Djoonk/ESP_Motor_test/(list of files, drawings)

Other design files:
Sheme/Motor_test.dch
Sheme/Motor_test.dip
