Djoonk/ESP_Motor_test/(commit log)

2026-07-24 Змінив команди з текстових на бінарні
2026-07-28 виправлено строку 142 uint8_t packet[4]
2026-08-03 Bidirectional DSHOT працює, але ще є питання по декодуванню пакету
2026-08-05 Додано передачу телеметрій кожну секунду, потрібно виправити перемикання протоколів та виправити PWM
2026-08-06 виправлено функцію газу для dshot, виправлено перемикання протоколів
2026-08-07 Прибрано затримку армінку
2026-08-11 Стабільне переключення протоколів. Напруга показується некоректно
2026-08-11 додано ініціалізацію ADC для заміру струму та напруги
2026-08-12 Додано замір напруги, відкалібровано. Зарезервовано струм та тягу
2026-08-12 Додано струм
2026-08-19 Додано тензодатчик, відкалібровано
2026-09-14 It works
    [Motor_test.dch, Motor_test.dip]
